MrVoelho/CrystalChamber/(commit log)

2024-12-10 CrystalChamber_G_ENGLISH
    Crystal Chamber Sketch - 04 december 2024
2024-12-12 CrystalChamber Thermostat Calibration
2024-12-12 Documentation file
    Crystal Chamber Documentation file
2024-12-12 Documentação
    Referência do projeto Crystal Chamber
